leheltorok/effect_cape_for_bela_mini/README.md

# Effect Cape for Bela Mini

A programmable open-platform effect pedal based on the Bela framework.

The objective of this project is to create a customizable guitar effects pedal using Bela's embedded computing framework. The pedal  allows guitarists to design and run their own effects on dedicated audio hardware. To achieve this, an extension cape has been developed, integrating essential components such as rotary encoders, switches, and audio inputs/outputs onto a single circuit. Additionally, a software framework has been created using Pure Data, providing all the necessary functions for utilizing the device.

Demo Video:
https://www.youtube.com/watch?v=Ah0W3sH00xs&ab_channel=LehelTorok

effect_cape

## Authors and acknowledgment

Lehel Török - 2023

I would like to express my gratitude to the Bela team for providing exceptional tutorials and their invaluable support on the community forum. Additionally, I extend my thanks to the user community for generously sharing excellent code examples, which serve as a solid foundation for all of us to build upon.

## License

Creative Commons Attribution-NonCommercial-ShareAlike 4.0 International License
https://creativecommons.org/licenses/by-sa/4.0/
