leheltorok/effect_cape_for_bela_mini/Case/effect_cape_case.pdf

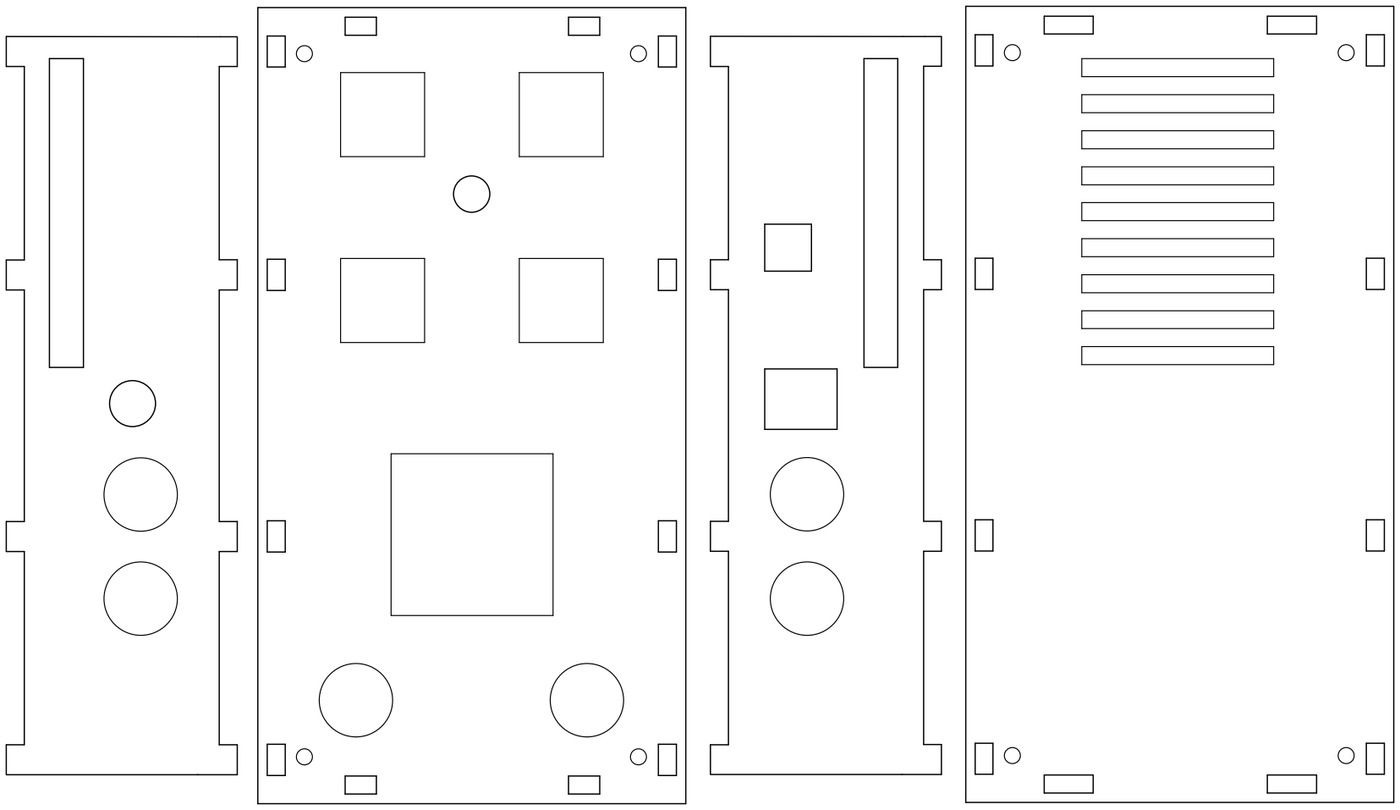
[picture p2: figure]
