leheltorok/effect_cape_for_bela_mini/Hardware/effect_cape_pcb.jpg

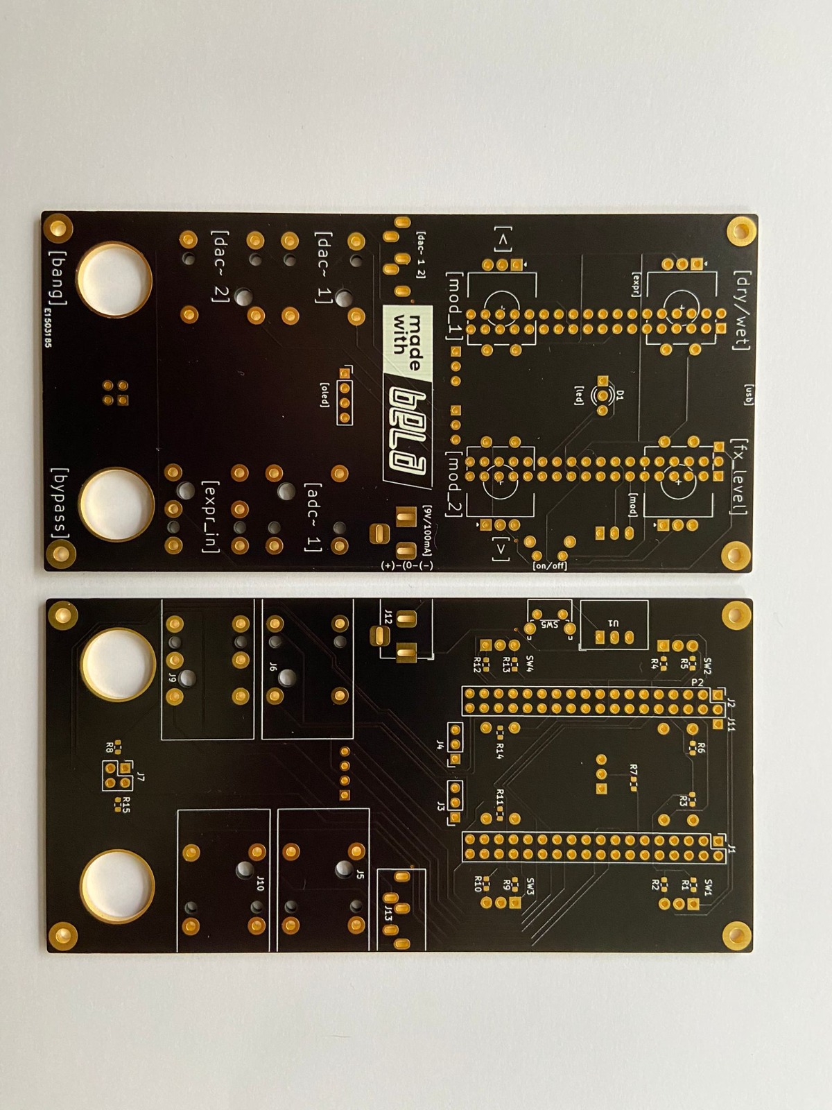
Hardware/effect_cape_pcb.jpg
