leheltorok/effect_cape_for_bela_mini/Pictures/case_2.JPG

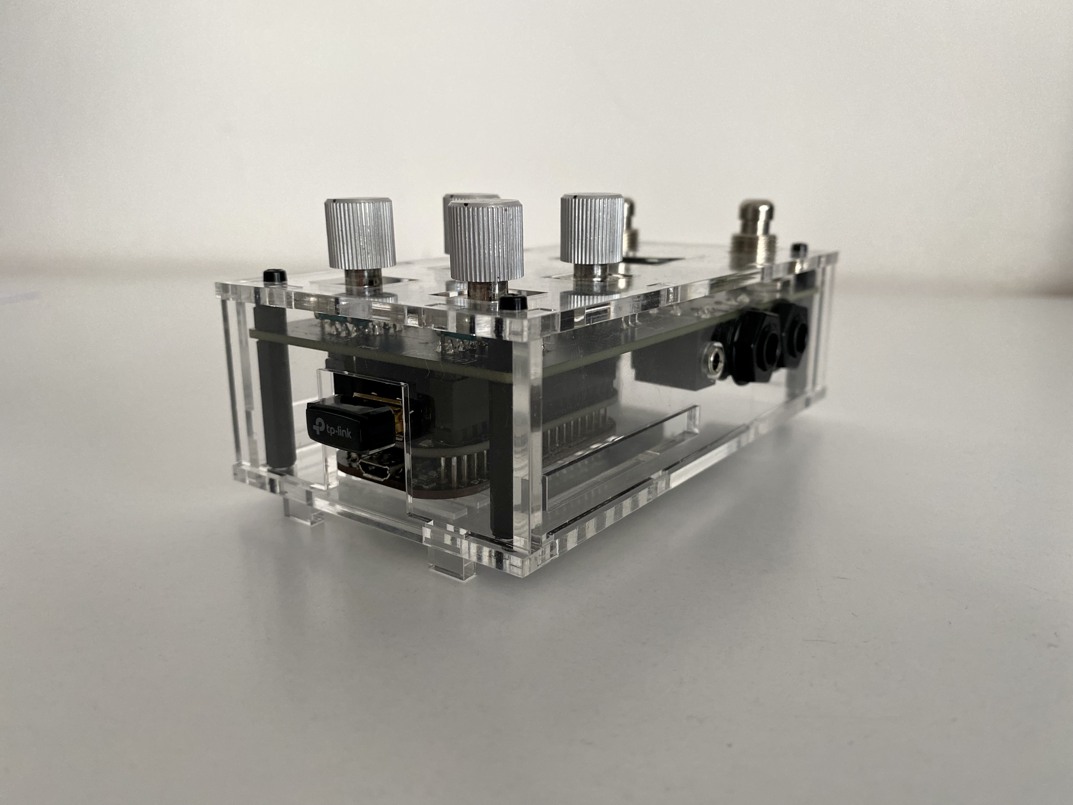
Pictures/case_2.JPG
