leheltorok/effect_cape_for_bela_mini/Pictures/case_3.JPG

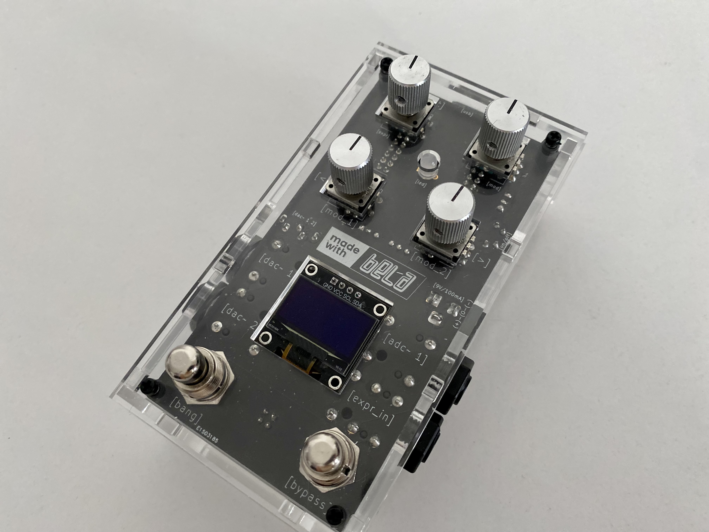
Pictures/case_3.JPG
