leheltorok/effect_cape_for_bela_mini/Pictures/case_6.JPG

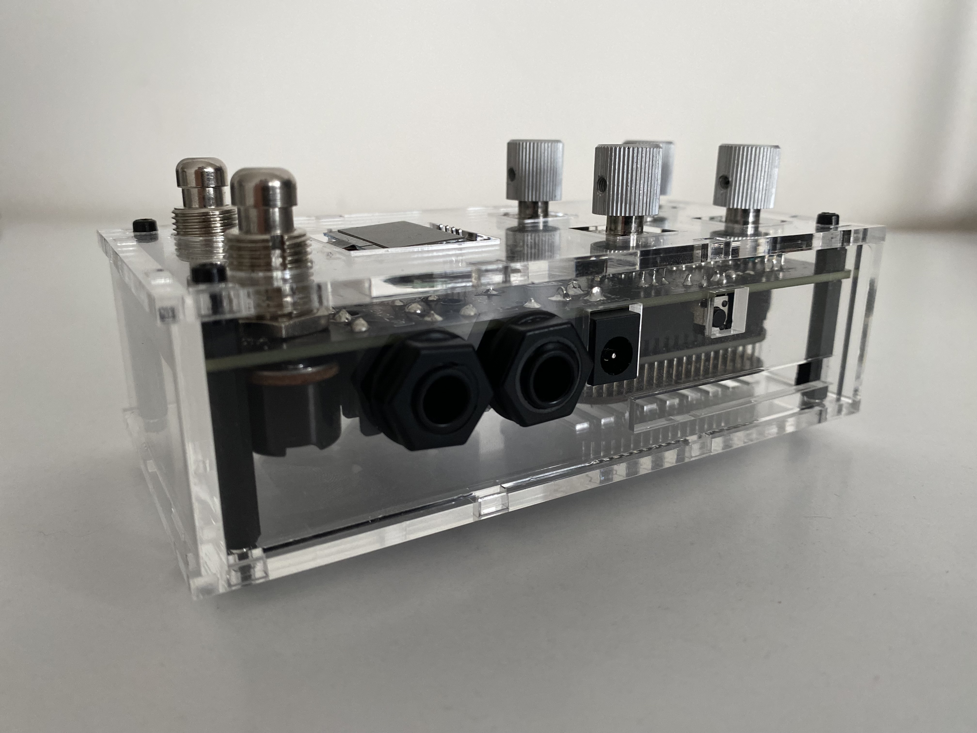
Pictures/case_6.JPG
