leheltorok/effect_cape_for_bela_mini/Pictures/effect_cape_4.jpg

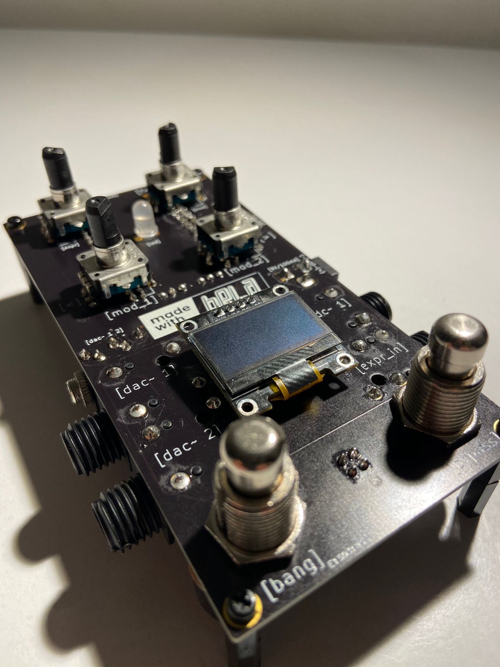
Pictures/effect_cape_4.jpg
