leheltorok/effect_cape_for_bela_mini/Pictures/effect_cape_6.jpg

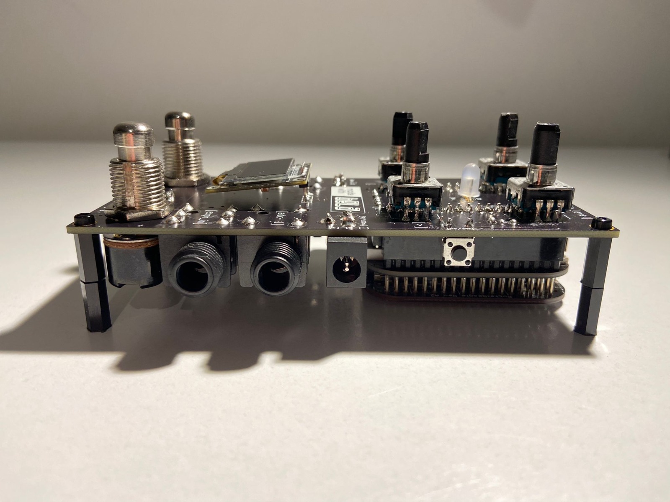
Pictures/effect_cape_6.jpg
