leheltorok/effect_cape_for_bela_mini/Hardware/Bill of Materials/readme.md

Link to access the interactive BOM:
https://www.dropbox.com/s/17bvmpcd8jzs7nz/ibom.html?dl=0
(this can serve as a useful reference for the build)
