leheltorok/effect_cape_for_bela_mini/Hardware/Schematic and PCB/effect_cape_rev1.kicad_pcb

## KiCad design Hardware/Schematic and PCB/effect_cape_rev1.kicad_pcb (2023-05-24)

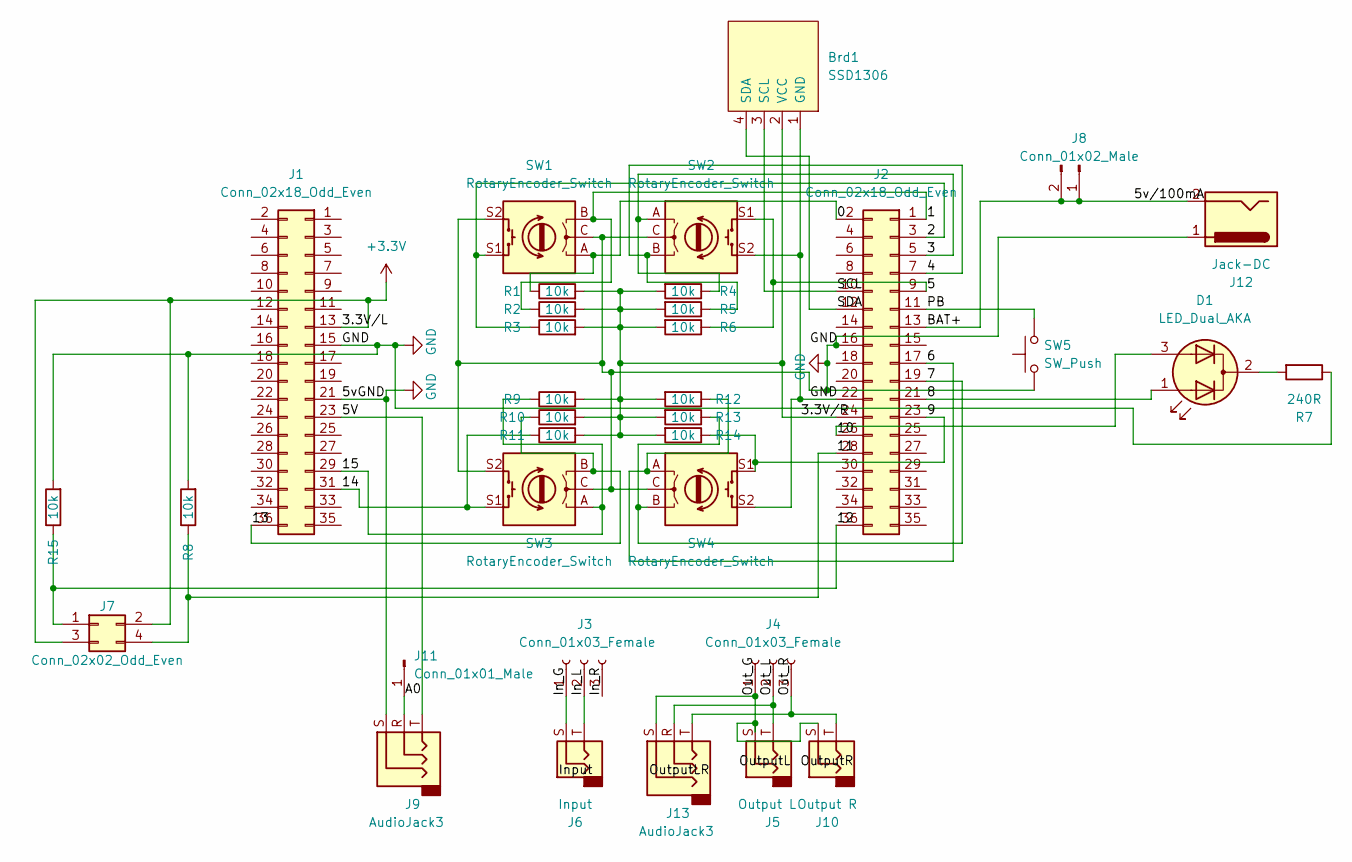
[picture p16: schematic effect_cape_rev1.kicad_sch]

Parts:
Brd1: SSD1306; PinSocket_1x04_P2.54mm_Vertical
D1: LED_Dual_AKA; LED_D3.0mm-3
J1, J2: Conn_02x18_Odd_Even; PinHeader_2x18_P2.54mm_Vertical
J3, J4: Conn_01x03_Female; PinSocket_1x03_P2.54mm_Vertical
J5: Output L; Jack_6.35mm_Neutrik_NRJ4HF_Horizontal
J6: Input; Jack_6.35mm_Neutrik_NRJ4HF_Horizontal
J7: Conn_02x02_Odd_Even; PinHeader_2x02_P2.54mm_Vertical
J8: Conn_01x02_Male; PinHeader_1x02_P2.54mm_Vertical
J9: AudioJack3; Jack_6.35mm_Neutrik_NRJ6HF_Horizontal
J10: Output R; Jack_6.35mm_Neutrik_NRJ4HF_Horizontal
J11: Conn_01x01_Male; PinHeader_1x01_P2.54mm_Vertical
J12: Jack-DC; BarrelJack_Horizontal
J13: AudioJack3; Jack_3.5mm_CUI_SJ1-3535NG_Horizontal
R1, R2, R3, R4, R5, R6, R8, R9, R10, R11, R12, R13, R14, R15: 10k; R_0603_1608Metric
R7: 240R; R_0603_1608Metric
SW1, SW2, SW3, SW4: RotaryEncoder_Switch; RotaryEncoder_Alps_EC11E-Switch_Vertical_H20mm
SW5: SW_Push; SW_Tactile_SPST_Angled_PTS645Vx58-2LFS

Connections:
+3V3: J1.13, J7.2, J7.3
/0: J2.2, R1.1, SW1.A
/1: J2.1, R2.1, SW1.B
/2: J2.3, R3.1, SW1.S1
/3: J2.5, R4.1, SW2.A
/3.3V/R: Brd1.2 (VCC), J2.24, R1.2, R2.2, R3.2, R4.2, R5.2, R6.2, R9.2, R10.2, R11.2, R12.2, R13.2, R14.2
/4: J2.7, R5.1, SW2.B
/5: J2.9, R6.1, SW2.S1
/5V: J1.23, J9.T
/5v/100mA: J2.13, J8.1, J8.2, J12.2
/6: J2.17, R12.1, SW4.A
/7: J2.19, R13.1, SW4.B
/8: D1.1 (A1), J2.21
/9: J2.23, R14.1, SW4.S1
/10: D1.3 (A2), J2.26
/11: J2.28, J7.4, R8.1
/12: J2.36, J7.1, R15.1
/13: J1.36, R10.1, SW3.B
/14: J1.31, R11.1, SW3.S1
/15: J1.29, R9.1, SW3.A
/A0: J9.R, J11.1
/In_G: J3.1, J6.S
/In_L: J3.2, J6.T
/In_R: J3.3
/Out_G: J4.1, J5.S, J10.S, J13.S; also elsewhere on the board
/Out_L: J4.2, J5.T, J13.R; also elsewhere on the board
/Out_R: J4.3, J10.T, J13.T; also elsewhere on the board
/PB: J2.11, SW5.2
/SCL: Brd1.3 (SCL), J2.10
/SDA: Brd1.4 (SDA), J2.12
GND: Brd1.1 (GND), J1.15, J1.21, J2.16, J2.22, J9.S, J12.1, R7.1, R8.2, R15.2, SW1.C, SW1.S2, SW2.C, SW2.S2, SW3.C, SW3.S2, SW4.C, SW4.S2, SW5.1
unnamed: D1.2 (K), R7.2

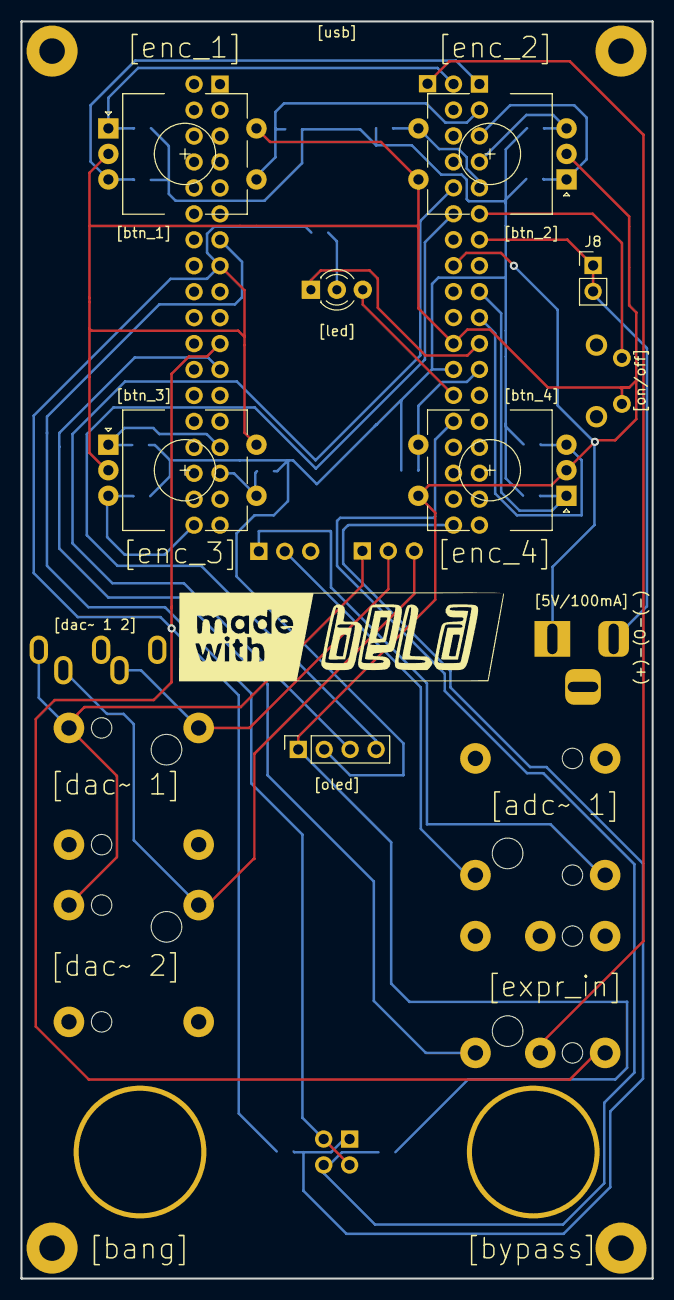
[picture p17: board effect_cape_rev1.kicad_pcb from above]

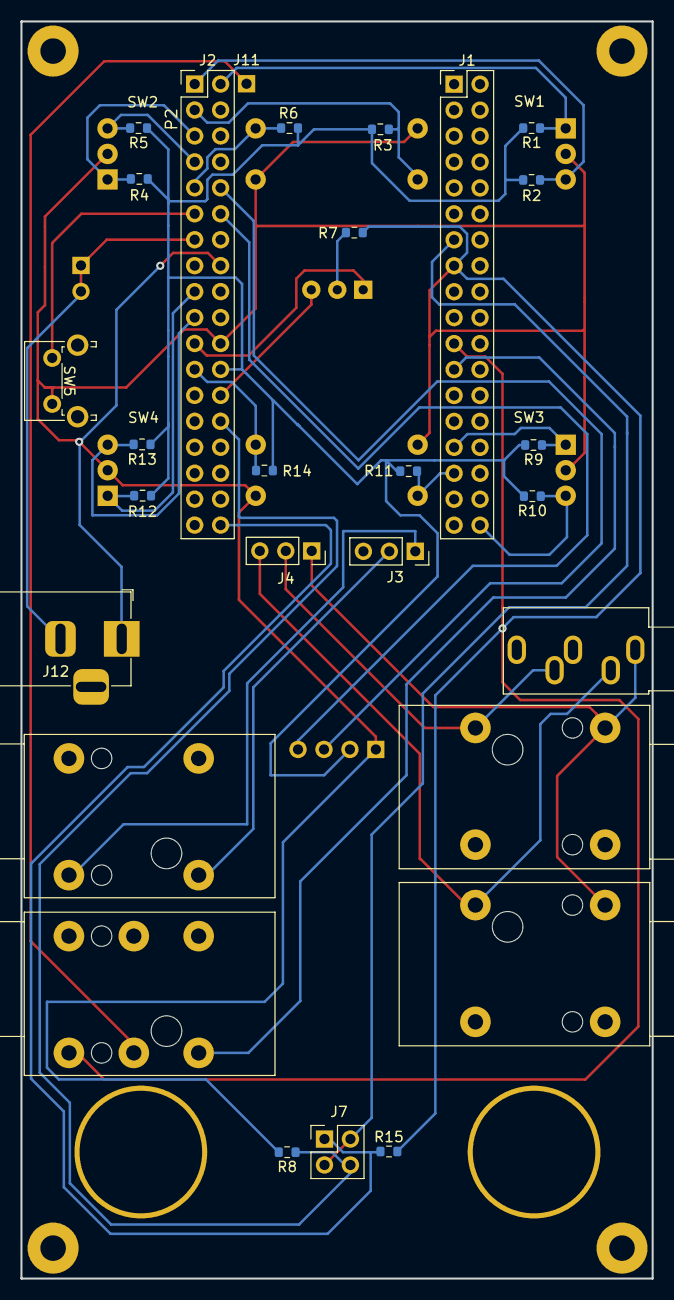
[picture p18: board effect_cape_rev1.kicad_pcb from below]

Board: 2 copper layers, 61.8 x 123.1 mm, 42 parts (28 on the bottom side), 31 nets.

Other parts of the board:
G: LOGO; madewithbela
Headphone Output (Stereo): AudioJack3; Jack_3.5mm_CUI_SJ1-3535NG_Horizontal
Momentary Footswitch: PF4520
Momentary Footswitch#2: PF4520
Mounting Hole: 2.5mm
Mounting Hole#2, Mounting Hole#3, Mounting Hole#4: 2.5mm

Their connections:
/Out_G: Headphone Output (Stereo).S; also elsewhere on the board
/Out_L: Headphone Output (Stereo).R; also elsewhere on the board
/Out_R: Headphone Output (Stereo).T; also elsewhere on the board
