leheltorok/effect_cape_for_bela_mini/(commit log)

2023-05-23 Update Interactive BOM
2023-05-23 Upload New File
    [effect_cape_BOM_rev1.xlsx]
2023-05-24 Update Instructions for assembly.txt
2023-05-24 Update Instructions for assembly.md
2023-05-24 Update Guide for assembly.md
2023-06-22 Create Case
2023-06-24 Add files via upload
    Modified [encoder_in] and introduced [latency_fix] to enhance the speed at which value changes are displayed on the OLED screen.
